JacobTheCoder19/VR-Telepresence-Robot/3D_Models/motor_connector_tight.stl

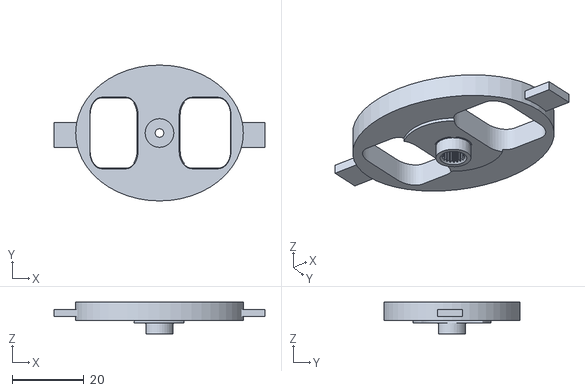
[picture p5: CAD file, 2026-10-20]
3D_Models/motor_connector_tight.stl
59.0 x 38.0 x 8.85
