JacobTheCoder19/VR-Telepresence-Robot/3D_Models/Robot Head LID v10.stl

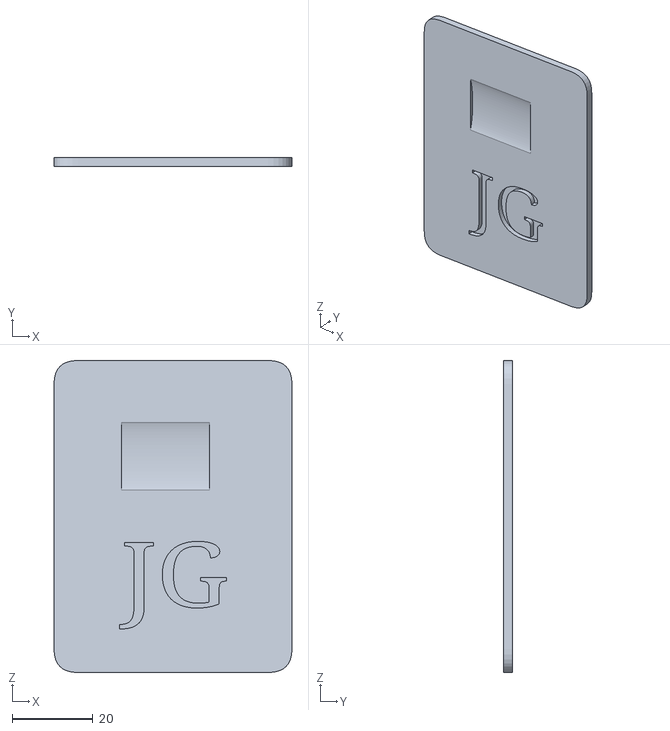
[picture p6: CAD file, 2026-10-16]
3D_Models/Robot Head LID v10.stl
58.9 x 2.14 x 77.3
