JacobTheCoder19/VR-Telepresence-Robot/3D_Models/Robot Head Holder v1.stl

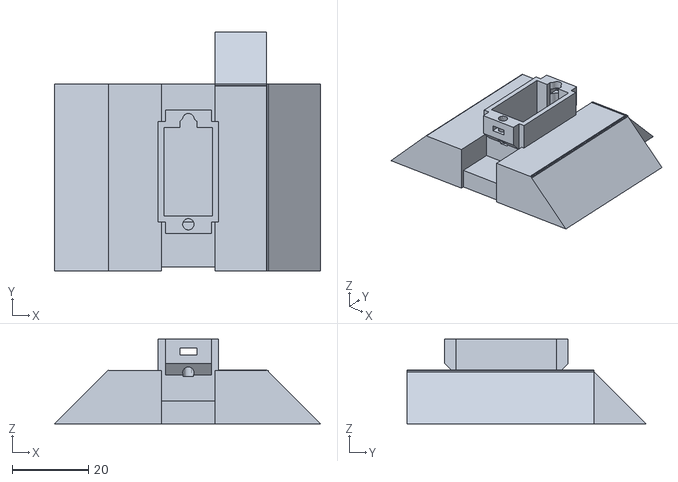
[picture p7: CAD file, 2026-10-16]
3D_Models/Robot Head Holder v1.stl
69.7 x 62.6 x 22.2
