JacobTheCoder19/VR-Telepresence-Robot/3D_Models/robot neck v1(V2 NOW) (1).stl

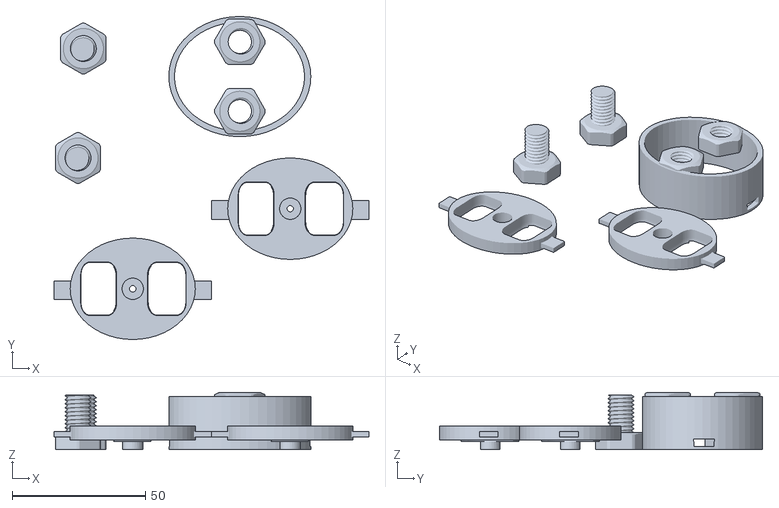
[picture p8: CAD file, 2026-10-16]
3D_Models/robot neck v1(V2 NOW) (1).stl
118.0 x 121.0 x 21.5
