JacobTheCoder19/VR-Telepresence-Robot/3D_Models/Robot Head v10.stl

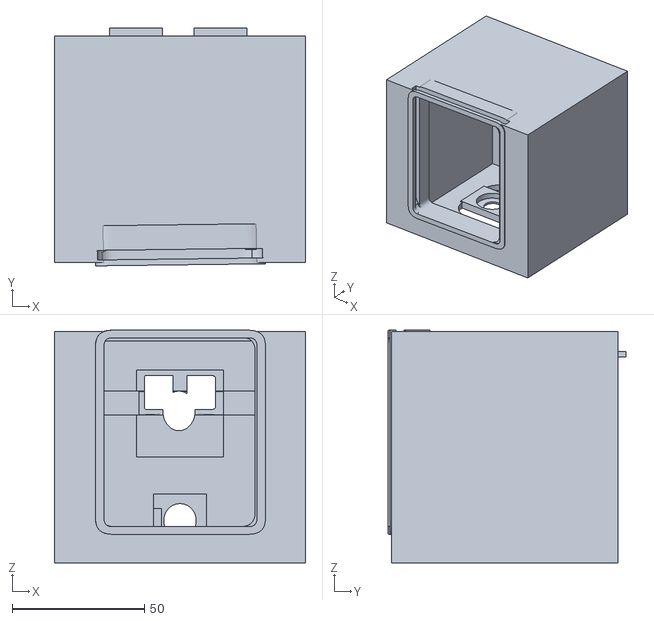
[picture p9: CAD file, 2026-10-16]
3D_Models/Robot Head v10.stl
95.0 x 90.0 x 88.1
