JacobTheCoder19/VR-Telepresence-Robot/(commit log)

2026-10-16 Added the STL files
    [Robot Head Holder v1.stl, Robot Head LID v10.stl, Robot Head v10.stl, robot neck v1(V2 NOW) (1).stl]
2026-10-16 Added the 3D Models
    [Robot Head Holder v1.stl, Robot Head LID v10.stl, Robot Head v10.stl, robot neck v1(V2 NOW) (1).stl]
2026-10-20 Redesigned the motor connector
    I noticed that the old motor connector would sometimes wear down and not be as snug. So, I redesigned this motor connector so that it fits better on the motor!
    [motor_connector_tight.stl]
